ProjectGroup15ECE411/Files/BILL_MATERIAL_Group15.xlsx

Bill Of Materials for [Team 15 Light Sensitive Alarm Clock]
source file: [UPDATED_PROJECT411Team15]
Last modified: 8th Nov, 2018
PCB version: 3 |  | P/DNP = | Place/Do Not Place component
BOM revision: 1
Cnt | Part References | P/DNP | Mfg | Mfg PN | Description | Distributor | Dist. PN | Cost Ea. | Cost Ext. | Notes
1 | 12MHZ Crystal | P | ECS Inc. | ECS-120-32-4X | CRYSTAL 12.0000MHZ 32PF T/H | Digikey | X1100-ND | 0.69 | 0.69
5 | C7, C8, C9, C10, C11 | P | AVX Corporation | SR205C104KAR | CAP CER 0.1UF 50V X7R RADIAL | Digikey | 478-3187-ND | 0.27 | 1.35
4 | C2, C3, | P | AVX Corporation | SR205C104KAR | CAP CER 0.1UF 50V X7R RADIAL | Digikey | 478-3187-ND | 0.27 | 1.08
1 | R8 | P | Bourns Inc. | 3310Y-025-103L | POT 10K OHM 1/4W PLASTIC LINEAR | Digikey | 3310Y-025-103L-ND | $3.65 | $3.56
5 | R2, R3, R4, R5, R7 | P | Stackpole Electronics Inc. | CF14JT10K0 | RES 10K OHM 1/4W 5% AXIAL | Digikey | CF14JT10K0CT-ND | 0.1 | 0.5
2 | C1, C5 | P | KEMET | C317C180J2G5TA | CAP CER 18PF 200V NP0 RADIAL | Digikey | 399-9760-ND | 0.43 | 0.86
1 | R6 | P | Yageo | CFR-25JB-52-1K | RES 1K OHM 1/4W 5% AXIAL | Digikey | 1.0KQBK-ND | 0.1 | 0.1
1 | R1 | P | Yageo | CFR-25JB-52-220R | RES 220 OHM 1/4W 5% AXIAL | Digikey | 220QBK-ND | 0.1 | 0.1
1 | T1 | P | Central Semiconductor Corp | 2N2222A | TRANS NPN 40V 0.8A TO-18 | Digikey | 2N2222ACS-ND | 2.34 | 2.34
1 | U1 | P | Microchip Technology | ATMEGA328-PU | IC MCU 8BIT 32KB FLASH 28DIP | Digikey | ATMEGA328-PU-ND | 1.96 | 1.96
1 | J1 | P | NA | FT232RL | FT232RL FTDI USB To TTL Serial Converter Adapter Module For Arduino | Banggood | NA | 3.09 | 3.09
1 | D1 | P | Advanced Photonix | PDV-P8103 | PHOTOCELL 16-33KOHM | Digikey | PDV-P8103-ND | 0.89 | 0.89
4 | S1, S2, | P | OMRON | NA | Little clicky switches are standard input "buttons" on electronic projects. | adafruit | NA | 2.5 | 10
1 | J2 | P | CUI Inc. | PJ-037A | CONN PWR JACK 2X5.5MM SOLDER | Digikey | CP-037A-ND | 0.58 | 0.58
1 | LM7805 | P | STMicroelectronics | L78S05CV | IC REG LINEAR 5V 2A TO220AB | Digikey | 497-1468-5-ND | 0.71 | 0.71
1 | SP1 | P | CUI Inc. | CMS-28528N-L152 | SPEAKER 8OHM 2W TOP PORT 99DB | Digikey | 102-3841-ND | 3.7 | 3.7
1 | DIS1 | P | Adafruit Industries LLC | 181 | STANDARD LCD 16X2 + EXTRAS | Digikey | 1528-1502-ND | 9.95 | 9.95
Ver # | Changed in version |  |  |  |  |  | TOTAL COST: |  | $41.46
1 | Initial BOM.
