ProjectGroup15ECE411/Files/Trial_1_ECE411.pdf

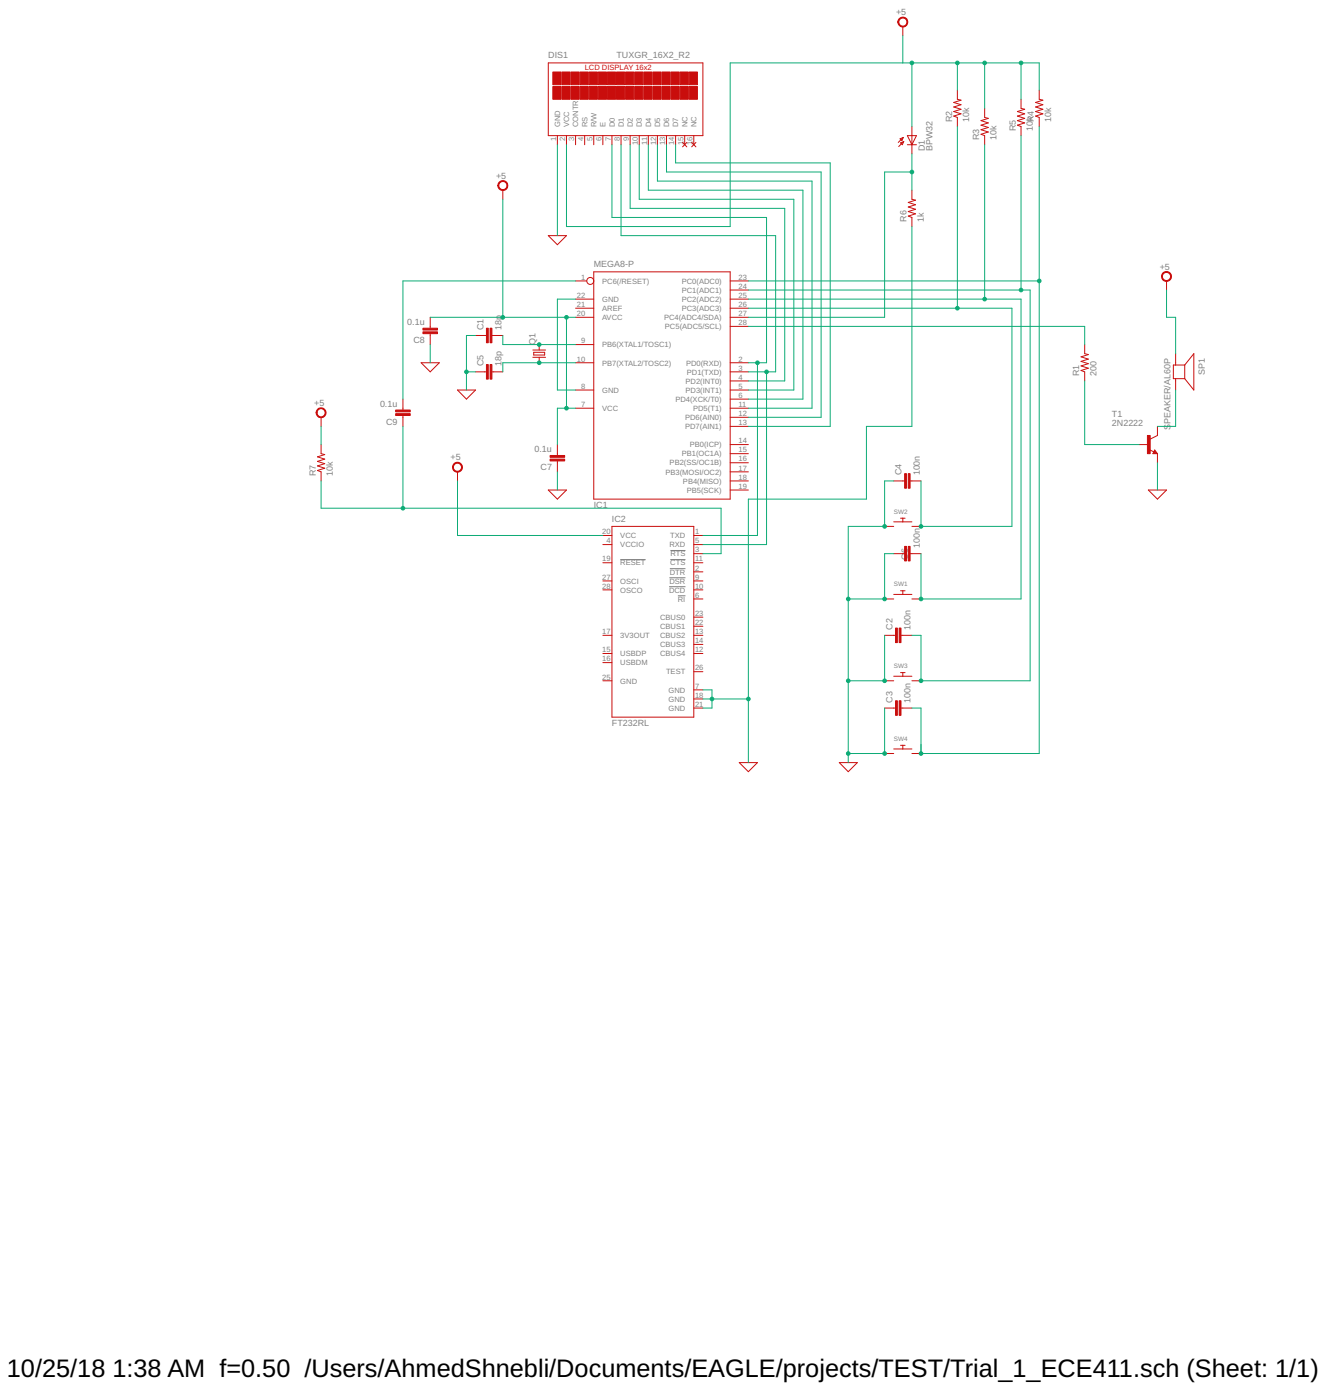
[picture p3: page 1]

10/25/18 1:38 AM f=0.50 /Users/AhmedShnebli/Documents/EAGLE/projects/TEST/Trial_1_ECE411.sch (Sheet: 1/1)
