ProjectGroup15ECE411/Files/ece411-t15-light-sensitive-alarm-clock.brd

## EAGLE design ece411-t15-light-sensitive-alarm-clock.brd (2018-12-06)

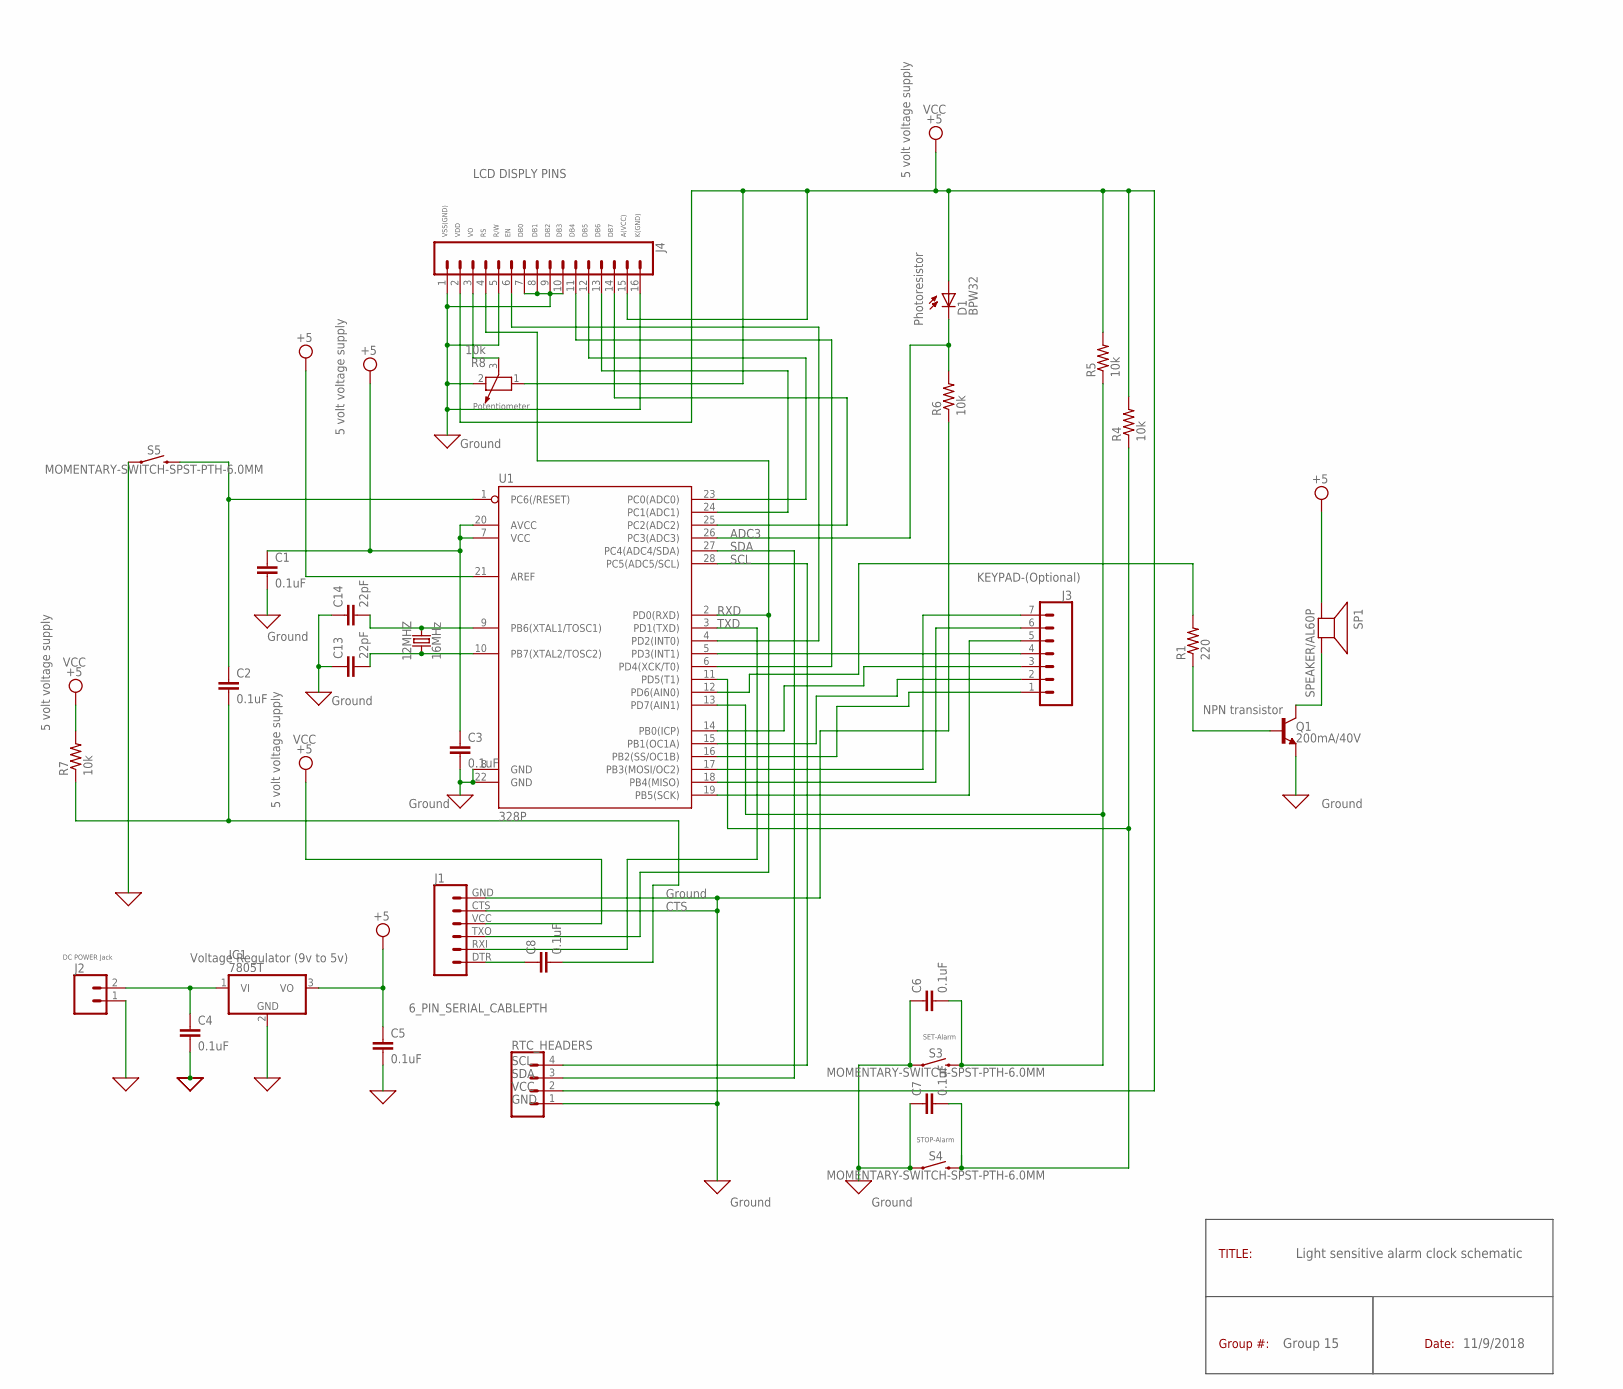
[picture p4: schematic ece411-t15-light-sensitive-alarm-clock.sch]

Parts:
12MHZ: 16MHz; CRYSTAL-PTH-2X6-CYL
C1, C2, C3, C4, C5, C6, C7, C8: 0.1uF; 0603
C13, C14: 22pF; 0603
D1: BPW32
IC1: 7805T; TO220H
J1: 6_PIN_SERIAL_CABLEPTH; FTDI_BASIC
J2: CONN_02; 1X02
J3: CONN_07; 1X07
J4: CONN_16; 1X16
Q1: 200mA/40V; TO-92
R1: 220; R0603
R4, R5, R6, R7: 10k; R0603
R8: 10k; PT-10
RTC_HEADERS: CONN_04; 1X04
S3, S4, S5: MOMENTARY-SWITCH-SPST-PTH-6.0MM; TACTILE_SWITCH_PTH_6.0MM
SP1: SPEAKER/AL60P; AL60P
U1: 328P; DIP28

Connections:
0: C1.2, C3.2, C4.2, C5.2, C6.1, C7.1, C13.1, C14.1, IC1.2 (GND), J1.CTS (5), J1.GND (6), J2.1, J4.1, J4.5, J4.7, J4.8, J4.9, J4.10, J4.16, Q1.1 (E), R6.1, R8.2, RTC_HEADERS.1, S3.1, S4.1, S5.1, U1.8 (GND), U1.22 (GND)
ADC0: C7.2, R4.1, S4.3 (2), U1.11 (PD5(T1))
ADC1: C6.2, R5.1, S3.3 (2), U1.13 (PD7(AIN1))
unnamed: 12MHZ.2, C14.2, U1.9 (PB6(XTAL1/TOSC1))
unnamed: 12MHZ.1, C13.2, U1.10 (PB7(XTAL2/TOSC2))
unnamed: Q1.3 (C), SP1.2 (-)
unnamed: Q1.2 (B), R1.1
unnamed: RTC_HEADERS.3, U1.27 (PC4(ADC4/SDA))
unnamed: C4.1, IC1.1 (VI), J2.2
unnamed: J1.RXI (2), U1.3 (PD1(TXD))
unnamed: RTC_HEADERS.4, U1.28 (PC5(ADC5/SCL))
unnamed: J1.TXO (3), J4.4, U1.2 (PD0(RXD))
unnamed: C8.1, J1.DTR (1)
unnamed: J4.3, R8.3
unnamed: J4.6, U1.4 (PD2(INT0))
unnamed: J3.4, U1.5 (PD3(INT1))
unnamed: R1.2, U1.12 (PD6(AIN0))
unnamed: J4.12, U1.23 (PC0(ADC0))
unnamed: J4.13, U1.24 (PC1(ADC1))
unnamed: D1.K (C), R6.2, U1.26 (PC3(ADC3))
unnamed: J4.14, U1.25 (PC2(ADC2))
unnamed: J3.3, U1.14 (PB0(ICP))
unnamed: C2.2, C8.2, R7.1
unnamed: J4.11, U1.6 (PD4(XCK/T0))
unnamed: J3.2, U1.15 (PB1(OC1A))
unnamed: J3.1, U1.16 (PB2(SS/OC1B))
unnamed: C2.1, S5.3 (2), U1.1 (PC6(/RESET))
unnamed: J3.7, U1.17 (PB3(MOSI/OC2))
unnamed: J3.6, U1.18 (PB4(MISO))
unnamed: J3.5, U1.19 (PB5(SCK))
VCC: C1.1, C3.1, C5.1, D1.A, IC1.3 (VO), J1.VCC (4), J4.2, J4.15, R4.2, R5.2, R7.2, R8.1, RTC_HEADERS.2, SP1.1 (+), U1.7 (VCC), U1.20 (AVCC), U1.21 (AREF)

Notes on the sheet:
5 volt voltage supply
LCD DISPLY PINS
Ground
Potentiometer
Light sensitive alarm clock schematic
Group 15
SCL
RXD
TXD
CTS
ADC3
SDA
TITLE:
Group #:
Date:
11/9/2018
VCC
Voltage Regulator (9v to 5v)
SET-Alarm
STOP-Alarm
Photoresistor
NPN transistor
GND
VSS(GND)
VDD
R/W
DB0
DB1
DB2
DB3
DB4
DB5
DB6
DB7
A(VCC)
K(GND)
DC POWER Jack
KEYPAD-(Optional)

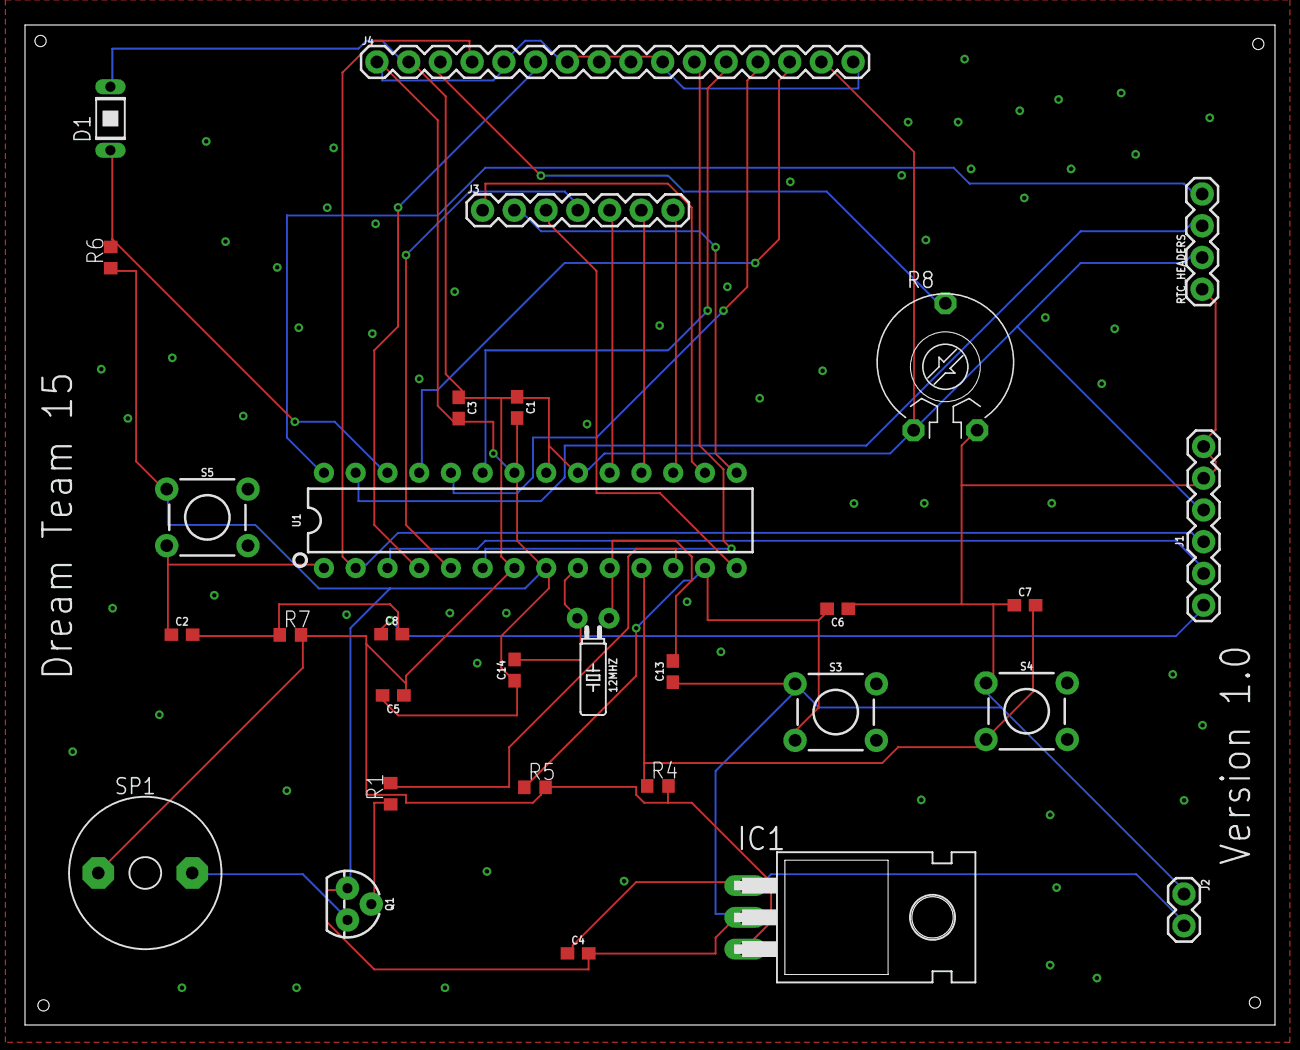
[picture p5: board ece411-t15-light-sensitive-alarm-clock.brd from above]

Board: 2 copper layers, 100.0 x 80.0 mm, 30 parts (0 on the bottom side), 31 nets.
