ProjectGroup15ECE411/Files/Trial_1_ECE411_Group_15_UPDATED.brd

## EAGLE design Trial_1_ECE411_Group_15_UPDATED.brd (2018-11-13)

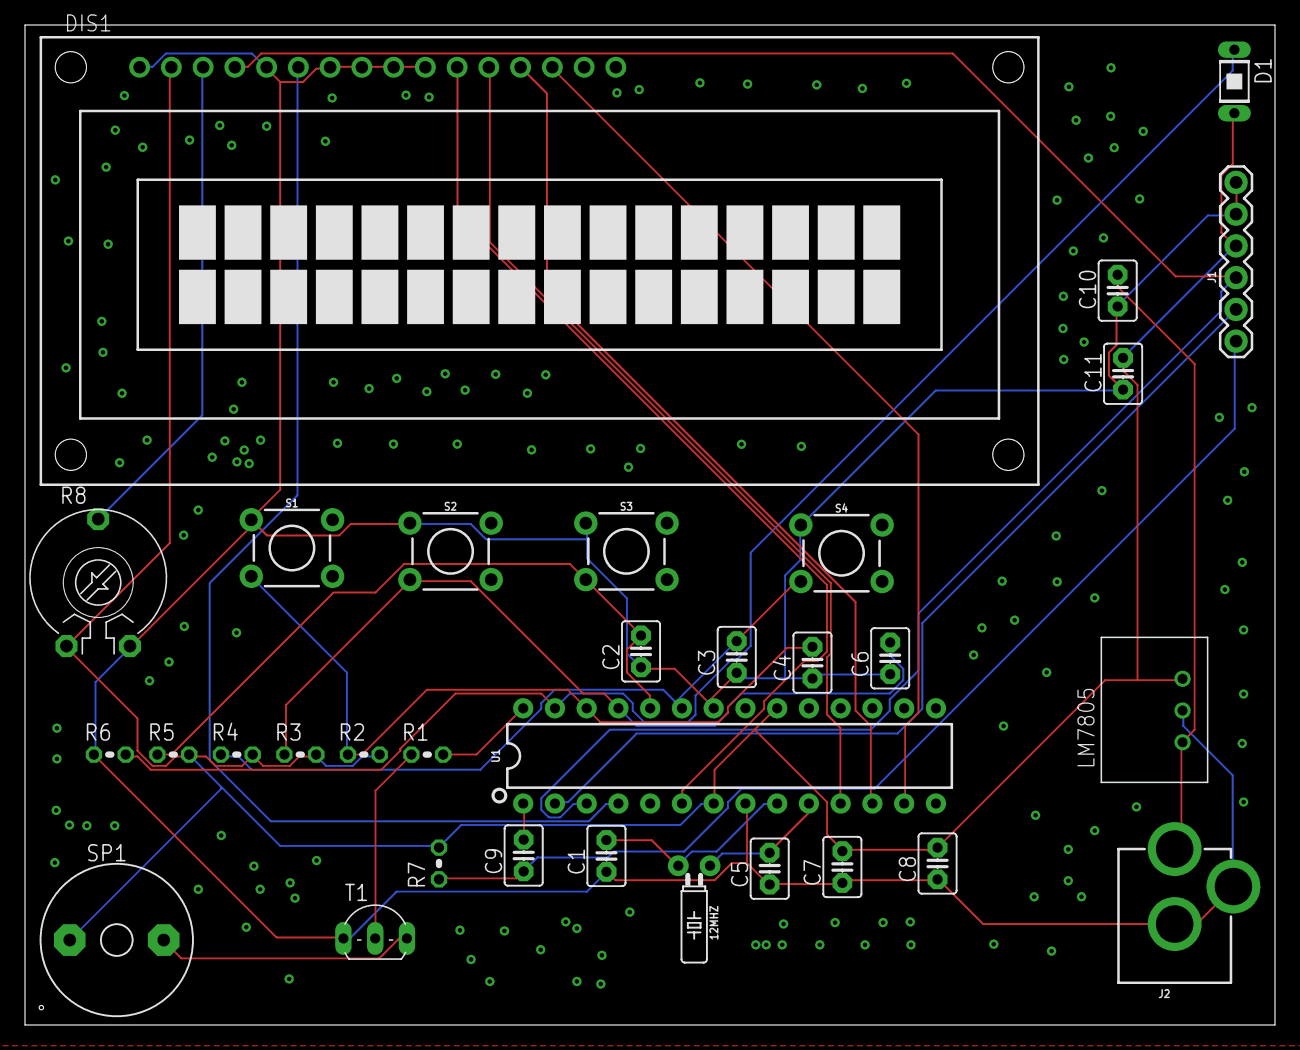
[picture p6: board Trial_1_ECE411_Group_15_UPDATED.brd from above]

Board: 2 copper layers, 100.0 x 80.0 mm, 32 parts (0 on the bottom side), 23 nets.

Parts:
12MHZ: CRYSTAL-PTH-2X6-CYL
C1, C5: 18p; C2.5-3
C2, C3, C4, C6: 100n; C2.5-3
C7, C8, C9, C10, C11: 0.1u; C2.5-3
D1: BPW32
DIS1: TUXGR_16X2_R2
J1: 6_PIN_SERIAL_CABLEPTH; FTDI_BASIC
J2: POWER_JACK; POWER_JACK_PTH
LM7805: R-78E5.0-1.0; DC-DC_CONVERTER_78XX
R1: 220; 0204V
R2, R3, R4, R5, R7: 10k; 0204V
R6: 1k; 0204V
R8: 10k; PT-10
S1, S2, S3, S4: MOMENTARY-SWITCH-SPST-PTH-6.0MM; TACTILE_SWITCH_PTH_6.0MM
SP1: SPEAKER/AL60P; AL60P
T1: 2N2222; TO92-EBC-OVAL
U1: 328P; DIP28

Connections:
0: C1.1, C2.1, C3.1, C4.1, C5.1, C6.1, C7.1, C8.1, C10.1, C11.1, DIS1.1, DIS1.5, DIS1.7, DIS1.8, DIS1.9, DIS1.10, J1.CTS, J1.GND, J2.GND, J2.GNDBREAK, LM7805.GND, R6.1, R8.2, S1.1, S2.1, S3.1, S4.1, T1.E, U1.8, U1.22
ADC0: C3.2, R4.1, S4.3, U1.23
ADC1: C2.2, R5.1, S3.3, U1.24
ADC2: C6.2, R3.1, S2.3, U1.25
ADC3: C4.2, R2.1, S1.3, U1.26
unnamed: 12MHZ.2, C1.2, U1.9
unnamed: 12MHZ.1, C5.2, U1.10
unnamed: SP1.2, T1.C
unnamed: R1.1, T1.B
unnamed: C10.2, J2.PWR, LM7805.VIN
unnamed: J1.RXI, U1.2
unnamed: DIS1.4, J1.TXO, U1.3
unnamed: DIS1.3, R8.3
unnamed: DIS1.11, U1.6
unnamed: DIS1.12, U1.11
unnamed: DIS1.13, U1.12
unnamed: DIS1.14, U1.13
unnamed: D1.K, R6.2, U1.27
unnamed: R1.2, U1.28
unnamed: C9.1, J1.DTR, R7.1
unnamed: DIS1.6, U1.4
unnamed: C9.2, U1.1
VCC: C7.2, C8.2, C11.2, D1.A, DIS1.2, J1.VCC, LM7805.VOUT, R2.2, R3.2, R4.2, R5.2, R7.2, R8.1, SP1.1, U1.7, U1.20
